ReliaSolve/Latent/(threads)

Thread 1 (2015-09-27):

Make better timestamps on VRPN Streaming Arduino server

russell-taylor, 2015-09-27:
It looks like the data from the arduino comes in bursts, so we should back-date the measurement time by the transmission delay for the number of characters in the buffer when that report was parsed from the time that the read returned the block of characters

russell-taylor, 2015-09-28:
Fixed in commit e23aa0ed6fffed647a198f31bffa1fbe8f36c8ff on the VRPN master branch.

balajyothi, 2015-09-28:
Hi Russell,

Can I have query on your blog regarding PNI sensor.

balajyothi, 2015-09-28:
Even I need to interface the PNI sensor for 3DOF with arduino ,can you help me on this.

russell-taylor, 2015-09-28:
The VRPN streaming Arduino server should let you read from sensors plugged into analogs, but it won't help with sensors that are read by other means.  It might be an example that could help you build such a thing.

balajyothi, 2015-09-28:
Hi Russell,

Thanks for the reply.

I need help the sensors reading data using arduino only.

On Mon, Sep 28, 2015 at 5:35 PM, Russell Taylor <notifications@github.com>
wrote:

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

--

   Regards,

   Mrs.V.B.N.Jyothi,
   Scientist-C,DST,
      NIOT,Chennai,India
         Ph:9940640947

Closed 2015-09-28.
