ReliaSolve/Latent/(commit log)

2015-09-12 Adding license terms. Adding program to enable setting a digital value and reading back an analog value to test the latency through the entire Arduino communications pipeline, including any analog-fi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
2015-09-12 Added base project build and start of program to test the Arduino latency.
2015-09-13 Implemented latency-testing program. It is not ever getting values larger than 0, which is a bug. Added some debug print statements. Still working on it.
2015-09-13 Modified the Arduino code to not expect a carriage return as part of the command -- now it gets a single 0 or 1 character.
2015-09-13 When the device has been reset by power cycling, this code runs fine. If we run again before the device is reset, it times out.
2015-09-13 This version can run even if the device has not just been reset. It has pretty high latencies, perhaps due to waiting for all reports before saying we've had a change.
2015-09-13 Tweaking the algorithm and making notes about various tests. This seems to be a stable version that gets around 4ms round-trip latency on my Arduino and it seems to be nearly optimal.
2015-09-13 Moved the Arduino program associated with the latency test under the latency test.
2015-09-13 Base class to handle spawning a thread per device to send reports back as fast as possible. Skeleton file without main() (does not compile) to check the latency of a VRPN tracker that will use derive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
2015-09-13 Added a generic VRPN analog DeviceThread class that can be started either using a factory or using a vrpn_Generic_Server_Object confiig file. Not yet tested.
2015-09-17 Can open and talk to the Arduino and a YEI analog device. There is trouble in the shut-down code, marked with XXX and @todo here. Also, there is a bug in VRPN that blocks on a semaphore during destru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
2015-09-26 Cleanly closing analog devices in a way that plays nicely with the threading.
2015-09-26 Estimates the update rates from each device.
2015-09-27 Adding code to keep track of where the user has sampled the angular space of the Arduino and filling in values from the analog channel. This version seg faults in the Service call for the device, so 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
2015-09-27 Fixing a thread race condition where the parent was not constructed, or was already destroyed, when the subclass thread was operating using its elements.
2015-09-27 Made the turn-around-detection code robust to small jitter in the Arduino values.
2015-09-27 Computes the range of Arduino measurements taken and the mean values for each. ToDo: Fill in something that lets it know when some intermediate values have no measured values; probably interpolate.
2015-09-27 Keeps track of the fast-move values read from both devices.
2015-09-28 Reversed the polarity of the time offset to make positive values mean that the device is behind the Arduino. Verified that it computes correct-polarity offsets by manually shifting the phase of motio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
2015-10-02 Generalized the VRPN analog latency tester into an analog or tracker latency tester. Trackers report position and Euler angles for sensor zero.
2015-10-09 Adding print out of offset.
2015-10-09 Added the ability to do latency comparison for either the reported times or the arrival times on the devices.
2015-10-09 Added test program to compare latency between two Arduino analog inputs.
2015-10-10 Added a filtered version of the vrpn_streaming_arduino program here that throws away about 1ms of reads on analog channels above 0 to handle the fact that it takes about 1ms for the phototransistor w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
2015-10-10 Adding description of how to reduce noise in the sensors.
2015-10-10 More document updates. Removed debugging print statement.
2015-10-12 Computes and prints statistics on the RenderManager latencies.
2016-04-29 Updating the build instructions to describe how the prototype unit was constructed.
2016-05-10 Updating document to warn about wiring routing.
